Cool-1-2-3-4-5/Stewart-Platform/Mechanical/CAD/Stewart Platform.SLDASM

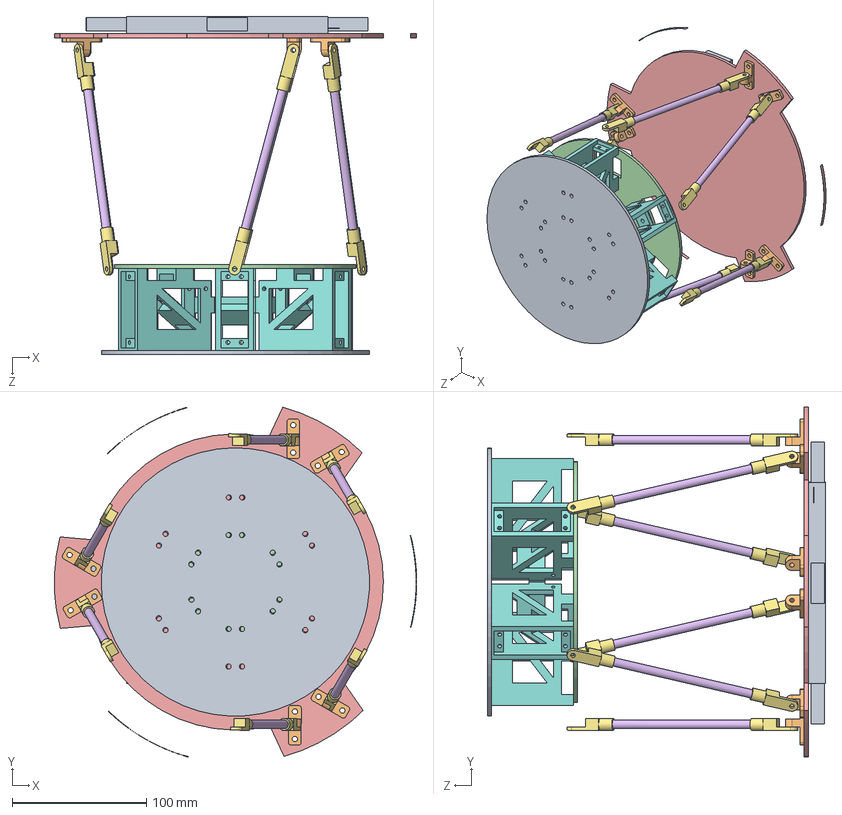
[picture p1: CAD file, 2026-11-09]
Mechanical/CAD/Stewart Platform.SLDASM
269.8 x 260.6 x 252.3 mm
Platform and Servo holder
Servo_HolderV.2 x 6
Aluminum holder x 12
Aluminum_Rod x 6
Top_Plane
Pi_mount
Start
bearingV2 x 6
Maze
