Cool-1-2-3-4-5/Stewart-Platform/Servo_Placers.SLDASM

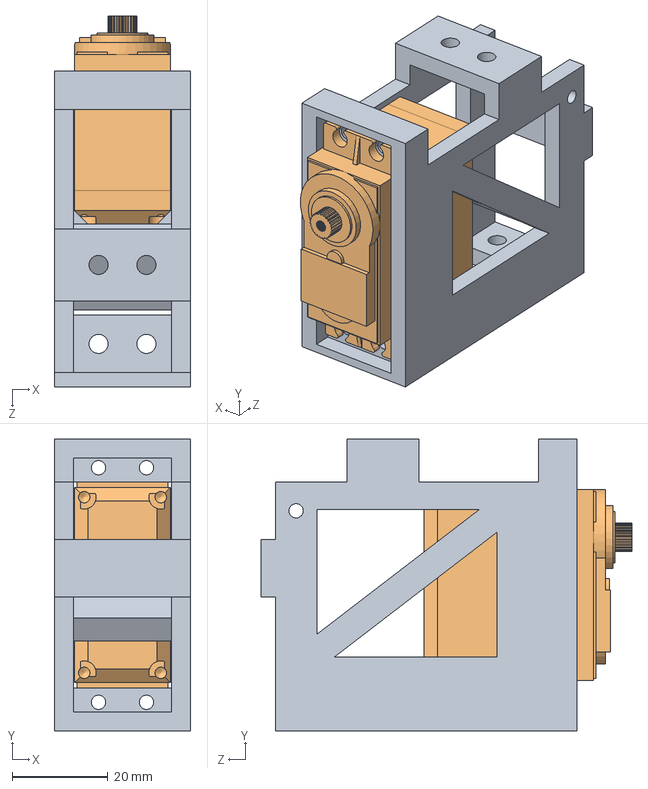
[picture p2: CAD file, 2026-10-27]
Servo_Placers.SLDASM
28.5 x 61.0 x 77.5 mm
Servo_HolderV.2
