Cool-1-2-3-4-5/Stewart-Platform/Stewart Platform.SLDASM

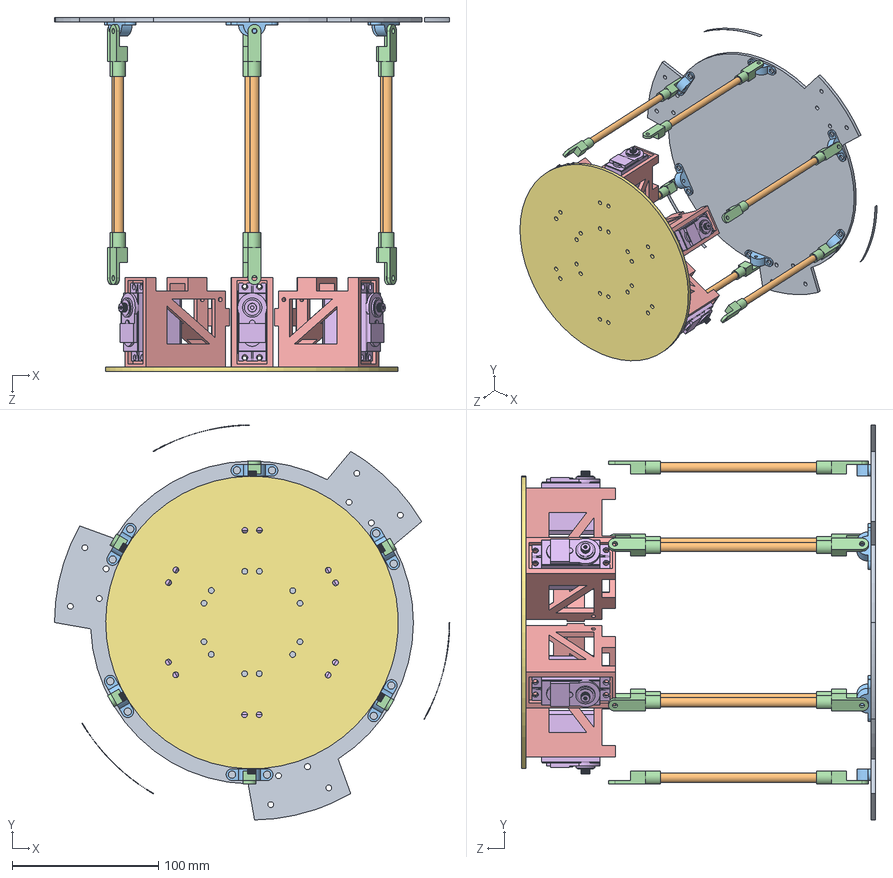
[picture p3: CAD file, 2026-10-27]
Stewart Platform.SLDASM
270.0 x 270.0 x 242.0 mm
Platform and Servo holder
Servo_HolderV.2 x 6
Aluminum holder x 12
Top_Bearing x 6
Aluminum_Rod x 6
Top_Plane
