Cool-1-2-3-4-5/Stewart-Platform/Mechanical/CAD/Maze.SLDPRT

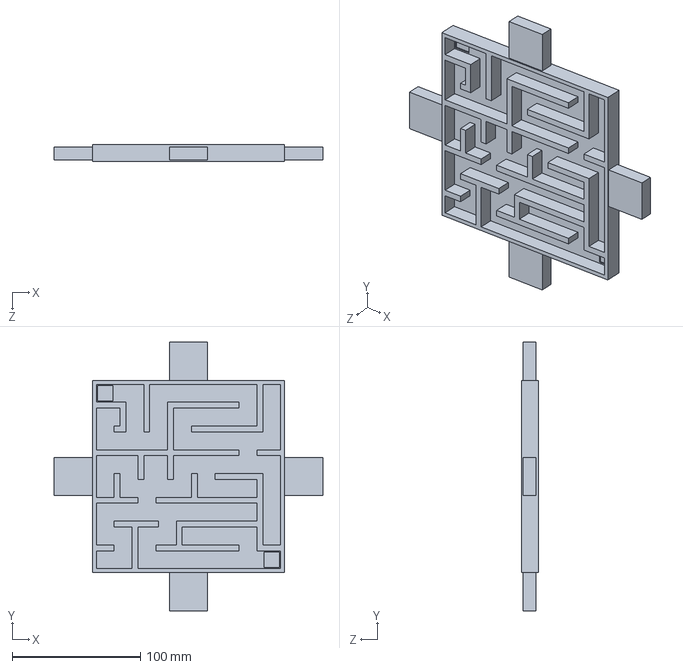
[picture p4: CAD file, 2026-11-09]
Mechanical/CAD/Maze.SLDPRT
210.0 x 210.0 x 13.0 mm
