Cool-1-2-3-4-5/Stewart-Platform/Mechanical/STL and DXF/bearingV2.STL

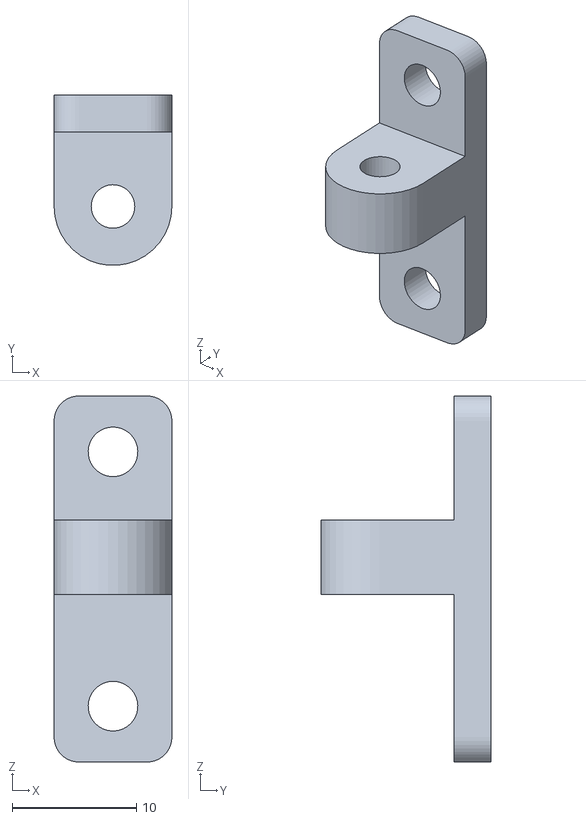
[picture p5: CAD file, 2026-11-09]
Mechanical/STL and DXF/bearingV2.STL
9.50 x 13.7 x 29.5
