Cool-1-2-3-4-5/Stewart-Platform/Platform and Servo holder.SLDPRT

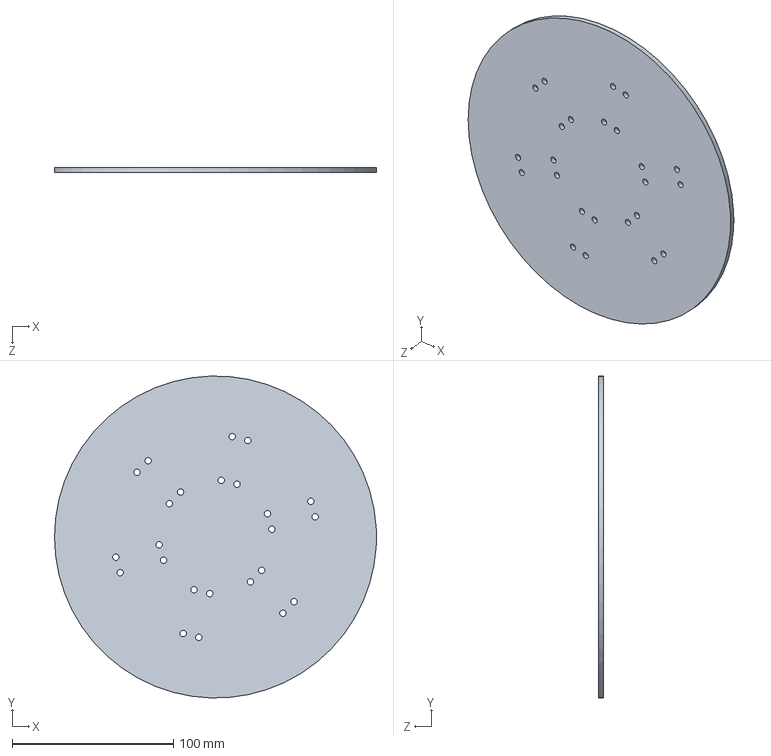
[picture p6: CAD file, 2026-10-27]
Platform and Servo holder.SLDPRT
200.0 x 199.9 x 3.17 mm
