Cool-1-2-3-4-5/Stewart-Platform/Mechanical/STL and DXF/Top_PlaneV3.DXF

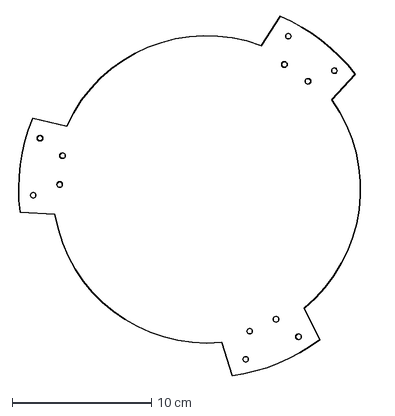
[picture p7: CAD file, 2026-11-09]
Mechanical/STL and DXF/Top_PlaneV3.DXF
26.0 x 25.8 cm
