Cool-1-2-3-4-5/Stewart-Platform/Servo_HolderV.5.STL

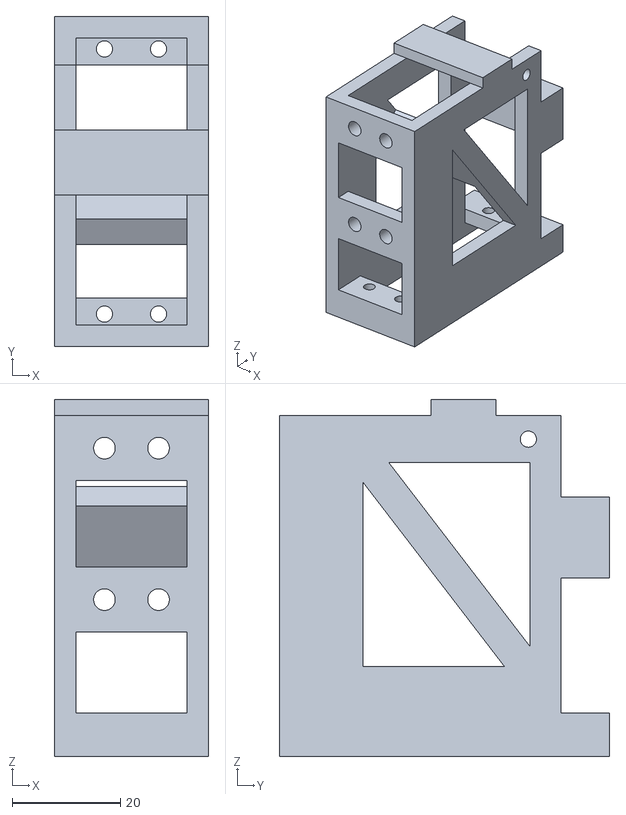
[picture p8: CAD file, 2026-10-27]
Servo_HolderV.5.STL
28.5 x 61.0 x 66.0
