Cool-1-2-3-4-5/Stewart-Platform/Bottom_PlateV3.DXF

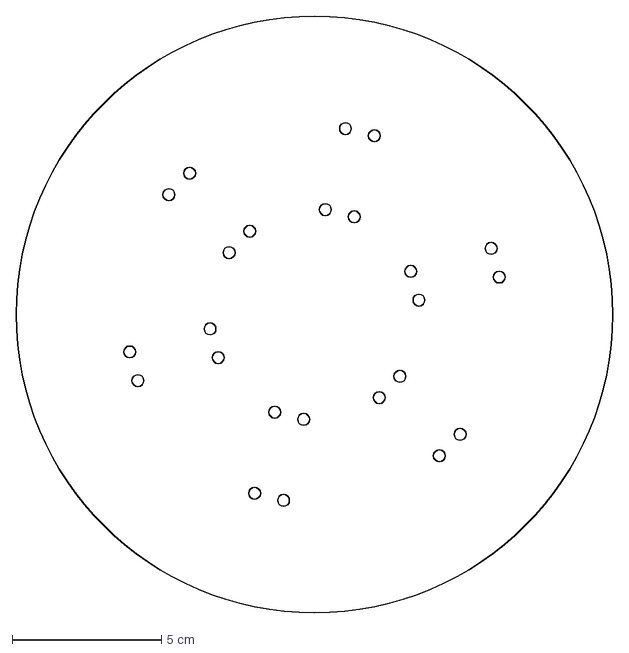
[picture p9: CAD file, 2026-10-27]
Bottom_PlateV3.DXF
20.0 x 20.0 cm
