Cool-1-2-3-4-5/Stewart-Platform/Mechanical/CAD/Top_Plane.SLDPRT

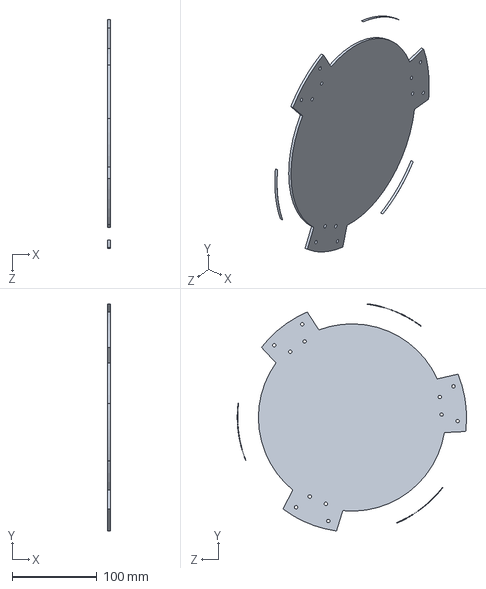
[picture p10: CAD file, 2026-11-09]
Mechanical/CAD/Top_Plane.SLDPRT
3.18 x 267.5 x 270.0 mm
