Cool-1-2-3-4-5/Stewart-Platform/Mechanical/STL and DXF/Maze_TopV2.DXF

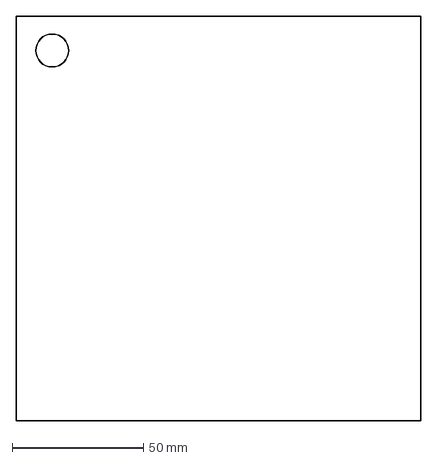
[picture p11: CAD file, 2026-11-05]
Mechanical/STL and DXF/Maze_TopV2.DXF
154.0 x 154.0 mm
