Cool-1-2-3-4-5/Stewart-Platform/Mechanical/STL and DXF/Maze.STL

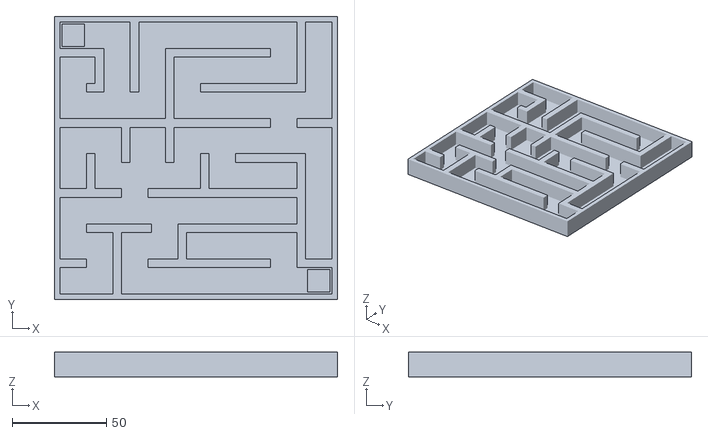
[picture p12: CAD file, 2026-11-05]
Mechanical/STL and DXF/Maze.STL
150.0 x 150.0 x 13.0
