Cool-1-2-3-4-5/Stewart-Platform/Mechanical/STL and DXF/Ball.STL

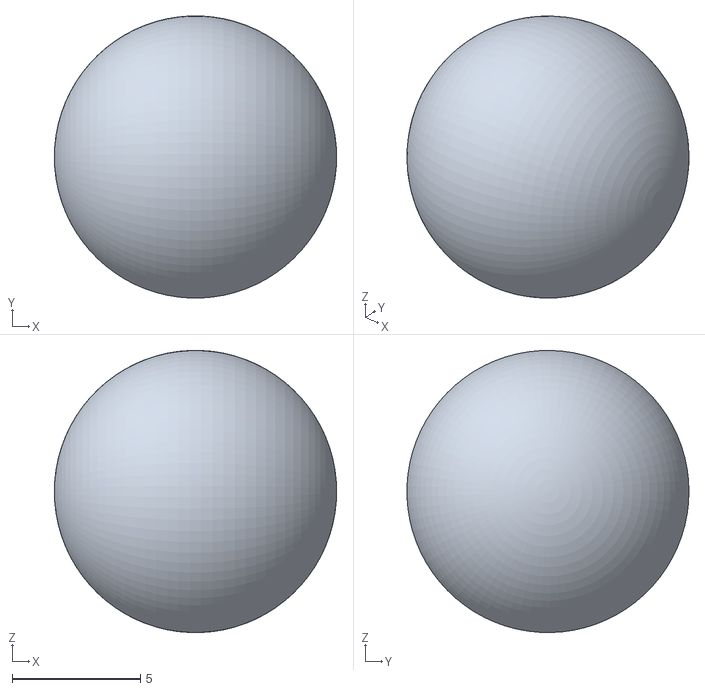
[picture p13: CAD file, 2026-11-05]
Mechanical/STL and DXF/Ball.STL
11.0 x 11.0 x 11.0
