Cool-1-2-3-4-5/Stewart-Platform/Servo_Holder.STL

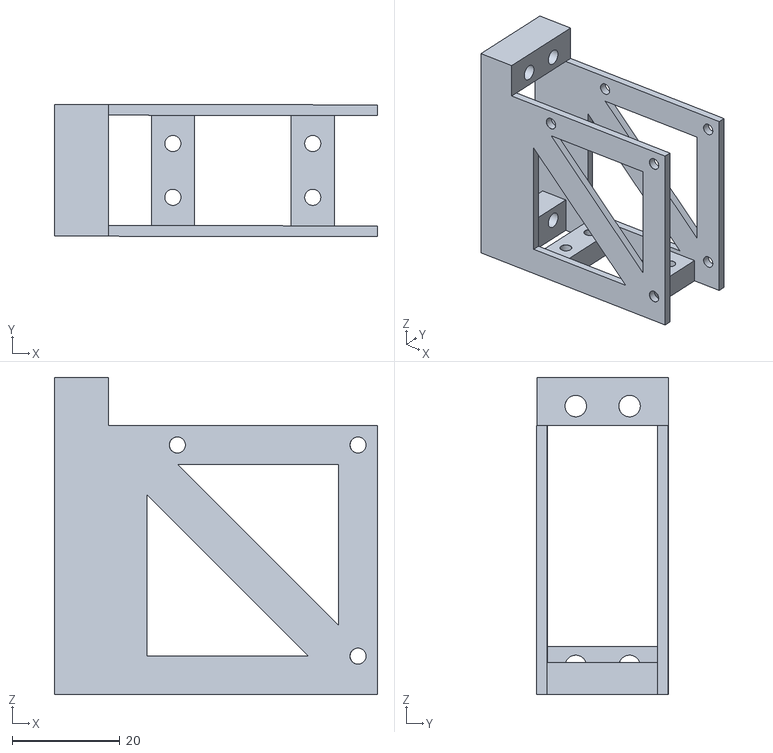
[picture p14: CAD file, 2026-10-27]
Servo_Holder.STL
60.0 x 24.6 x 59.0
