Cool-1-2-3-4-5/Stewart-Platform/Bottom_Plate.DXF

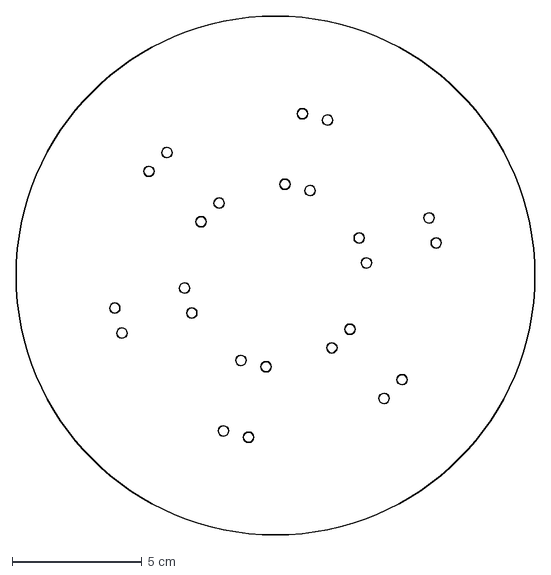
[picture p15: CAD file, 2026-10-27]
Bottom_Plate.DXF
20.0 x 20.0 cm
