Cool-1-2-3-4-5/Stewart-Platform/Mechanical/CAD/Aluminum holder.SLDPRT

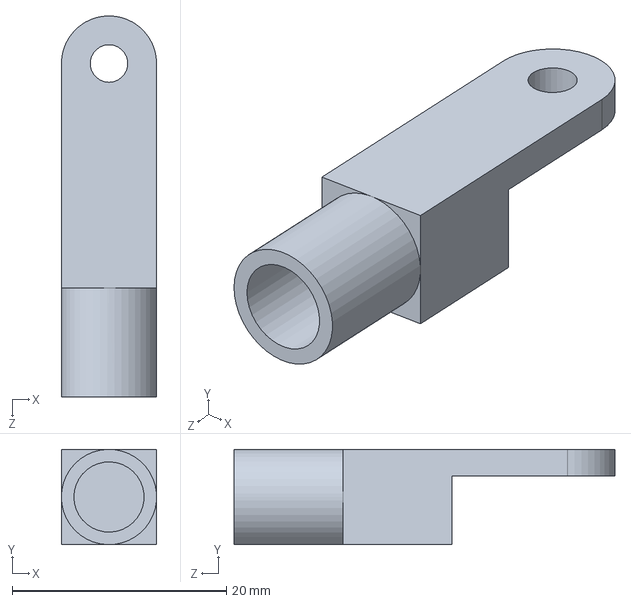
[picture p16: CAD file, 2026-11-09]
Mechanical/CAD/Aluminum holder.SLDPRT
8.89 x 8.89 x 35.5 mm
