Cool-1-2-3-4-5/Stewart-Platform/Mechanical/STL and DXF/Maze_top.DXF

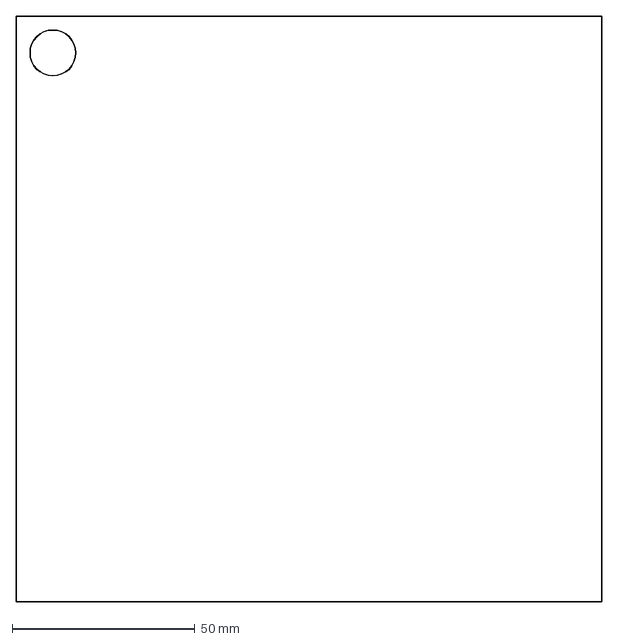
[picture p17: CAD file, 2026-11-05]
Mechanical/STL and DXF/Maze_top.DXF
160.0 x 160.0 mm
