Cool-1-2-3-4-5/Stewart-Platform/Mechanical/CAD/Pi_mount.SLDPRT

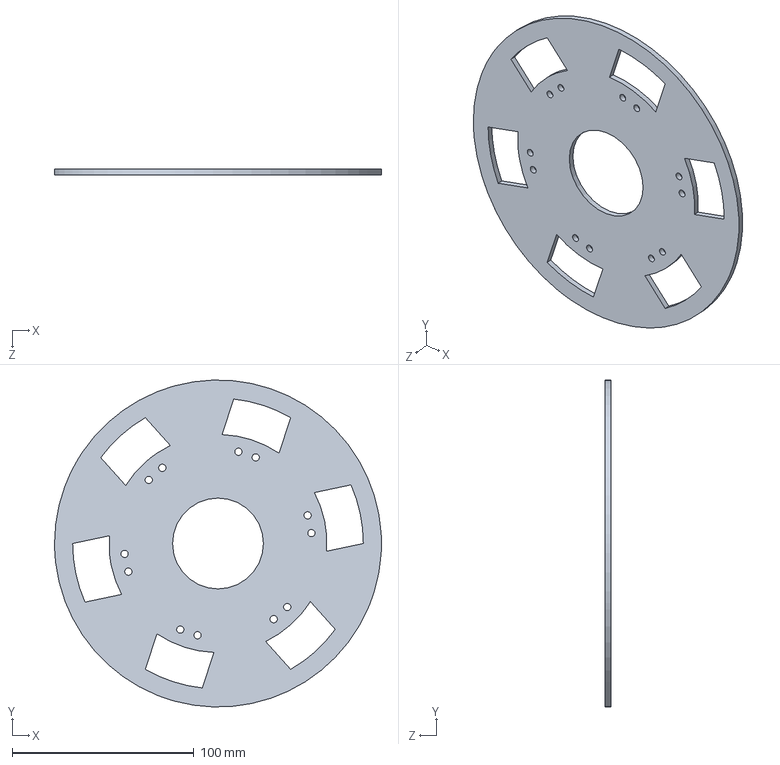
[picture p18: CAD file, 2026-11-09]
Mechanical/CAD/Pi_mount.SLDPRT
180.0 x 179.9 x 3.17 mm
