Cool-1-2-3-4-5/Stewart-Platform/Mechanical/STL and DXF/Pi_mountV2.DXF

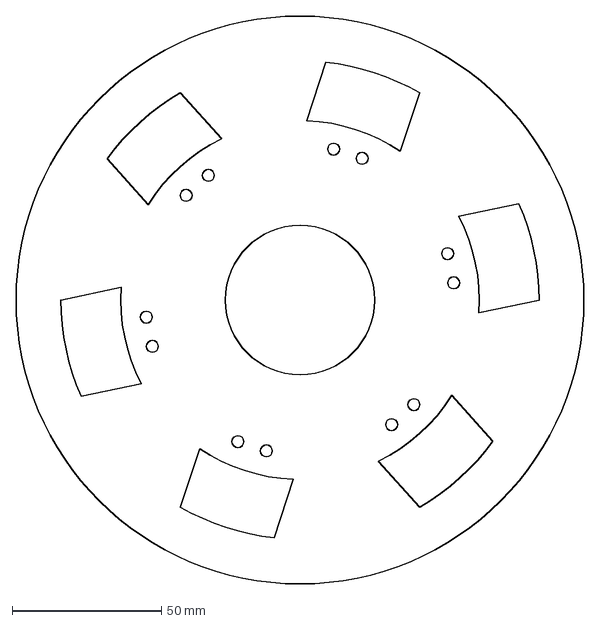
[picture p19: CAD file, 2026-11-05]
Mechanical/STL and DXF/Pi_mountV2.DXF
190.0 x 190.0 mm
