Cool-1-2-3-4-5/Stewart-Platform/2.45.SLDPRT

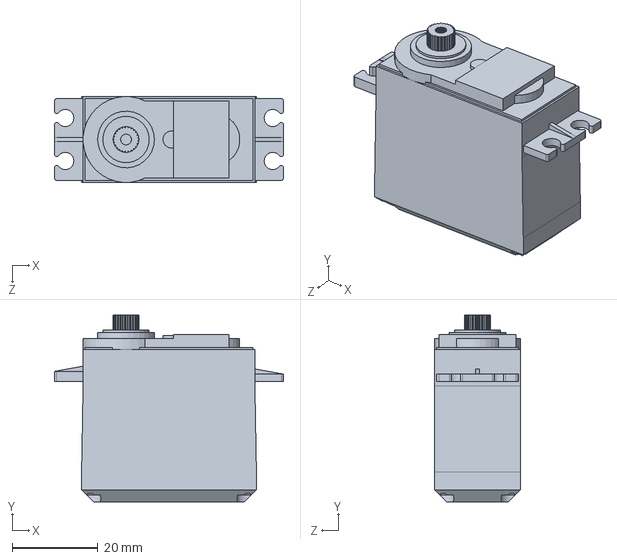
[picture p20: CAD file, 2026-10-27]
2.45.SLDPRT
53.3 x 43.5 x 20.0 mm
