Cool-1-2-3-4-5/Stewart-Platform/Mechanical/STL and DXF/Bottom_PlateV6.DXF

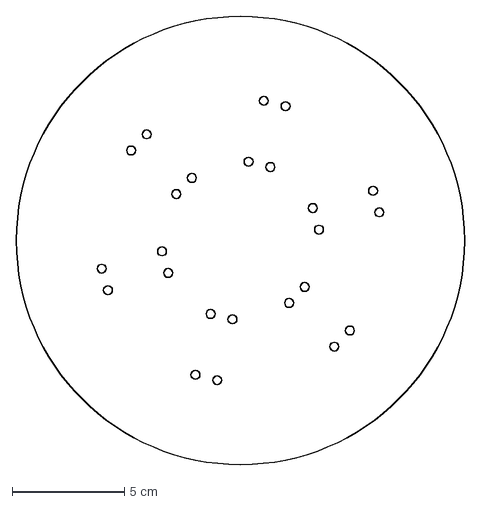
[picture p21: CAD file, 2026-11-05]
Mechanical/STL and DXF/Bottom_PlateV6.DXF
20.0 x 20.0 cm
