Cool-1-2-3-4-5/Stewart-Platform/Aluminium 25T Servo Horn.step

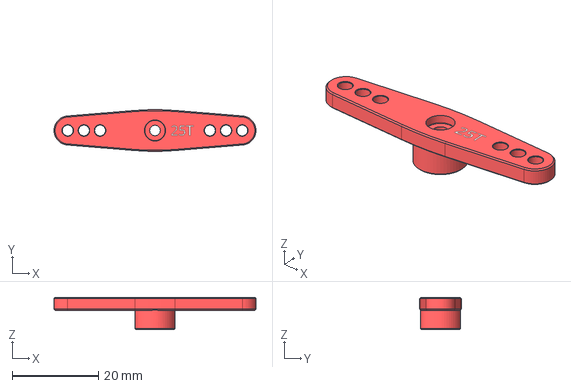
[picture p22: CAD file, 2026-10-27]
Aluminium 25T Servo Horn.step
46.9 x 9.66 x 7.50 mm
