Cool-1-2-3-4-5/Stewart-Platform/Mechanical/CAD/Maze_Top.SLDPRT

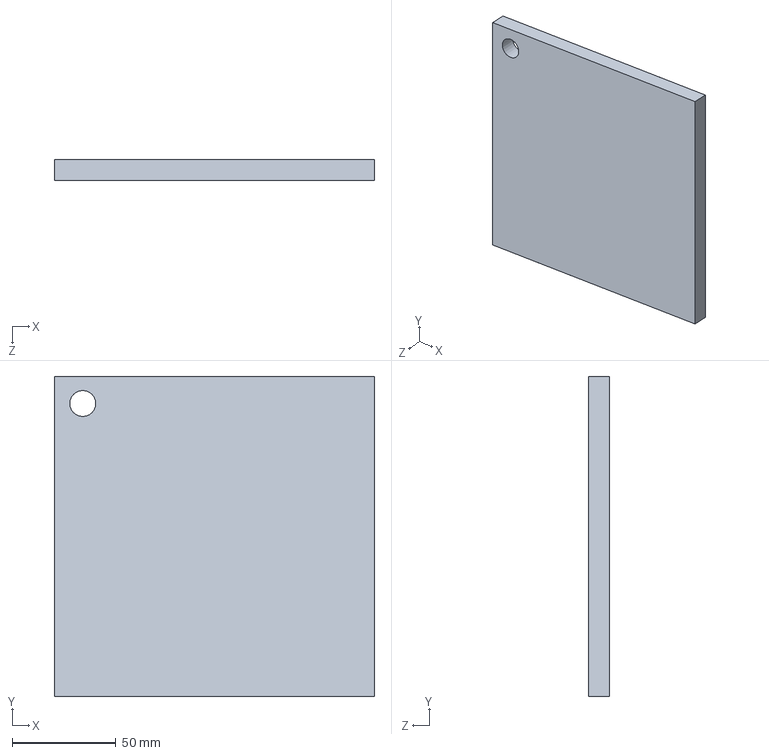
[picture p23: CAD file, 2026-11-05]
Mechanical/CAD/Maze_Top.SLDPRT
154.0 x 154.0 x 10.0 mm
