Cool-1-2-3-4-5/Stewart-Platform/Mechanical/CAD/Start.SLDPRT

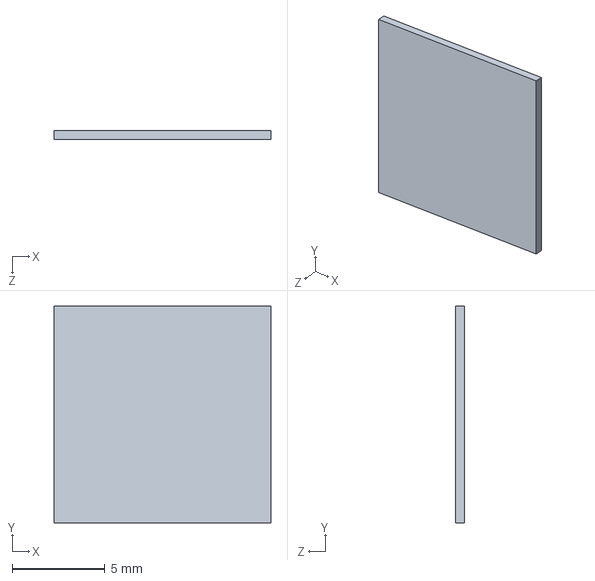
[picture p24: CAD file, 2026-11-05]
Mechanical/CAD/Start.SLDPRT
11.7 x 11.7 x 0.5 mm
