Cool-1-2-3-4-5/Stewart-Platform/Mechanical/CAD/Spacers.SLDPRT

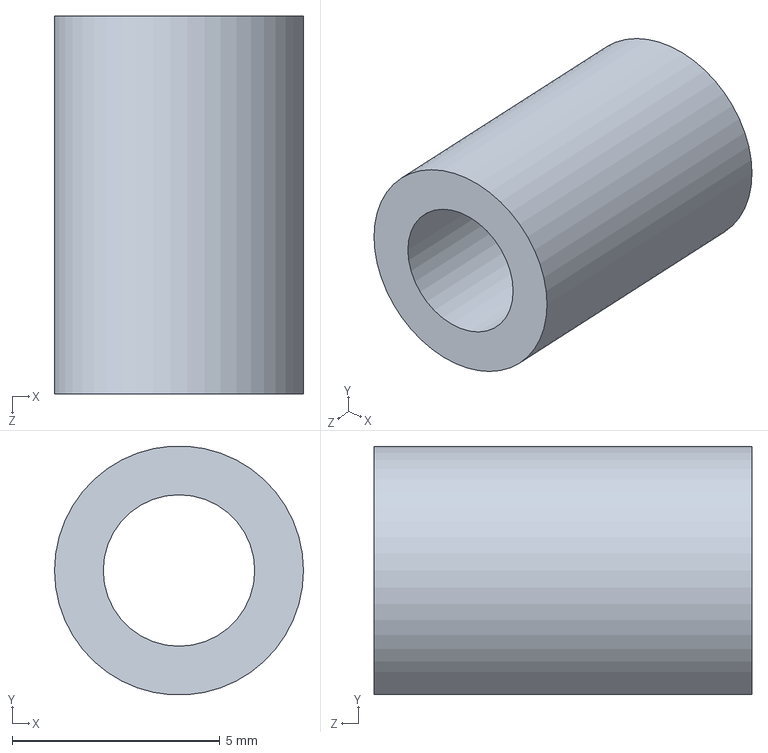
[picture p26: CAD file, 2026-10-30]
Mechanical/CAD/Spacers.SLDPRT
6.00 x 5.99 x 9.10 mm
