Cool-1-2-3-4-5/Stewart-Platform/Mechanical/CAD/Spacer.SLDPRT

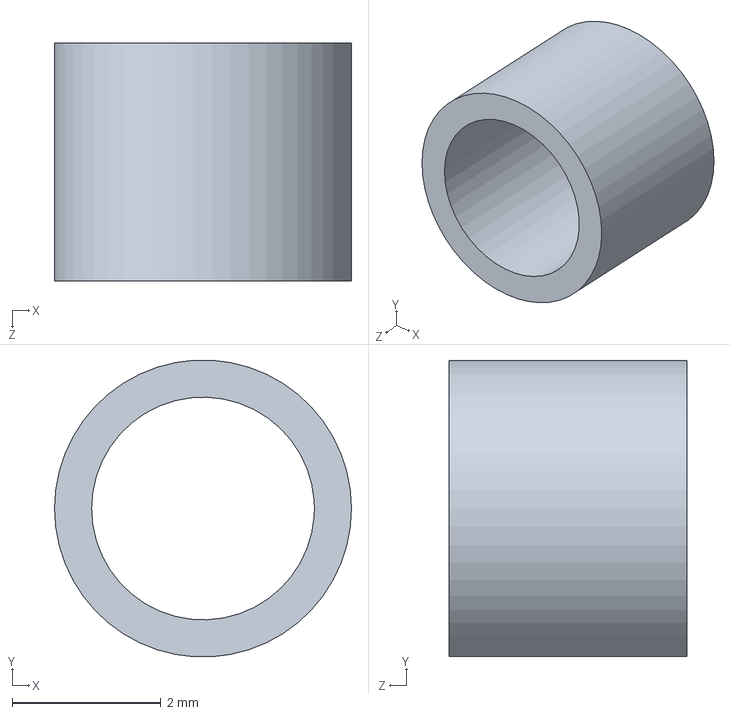
[picture p27: CAD file, 2026-10-29]
Mechanical/CAD/Spacer.SLDPRT
4.00 x 3.99 x 3.20 mm
