Cool-1-2-3-4-5/Stewart-Platform/Top_Plane.SLDPRT

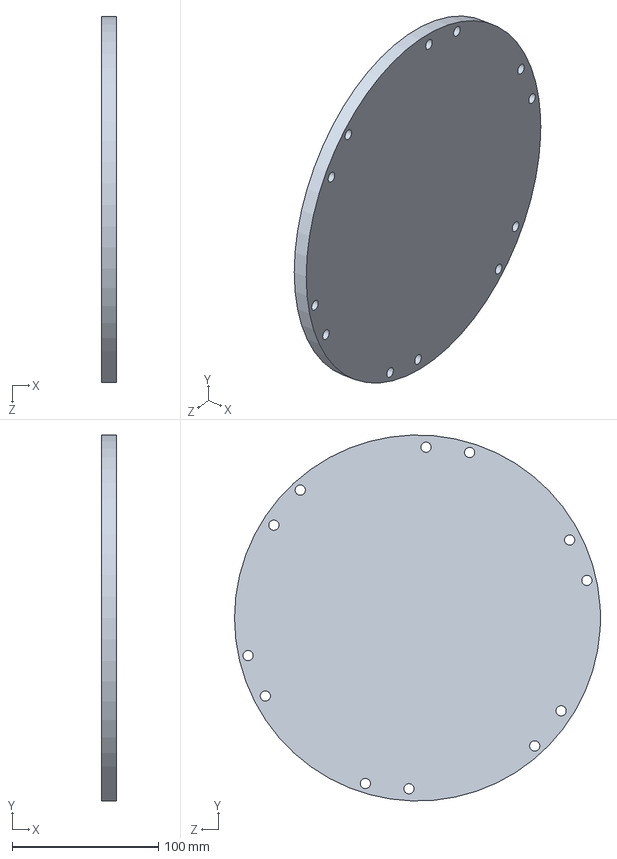
[picture p28: CAD file, 2026-10-27]
Top_Plane.SLDPRT
10.0 x 249.9 x 250.0 mm
