Cool-1-2-3-4-5/Stewart-Platform/Mechanical/CAD/Cap.SLDPRT

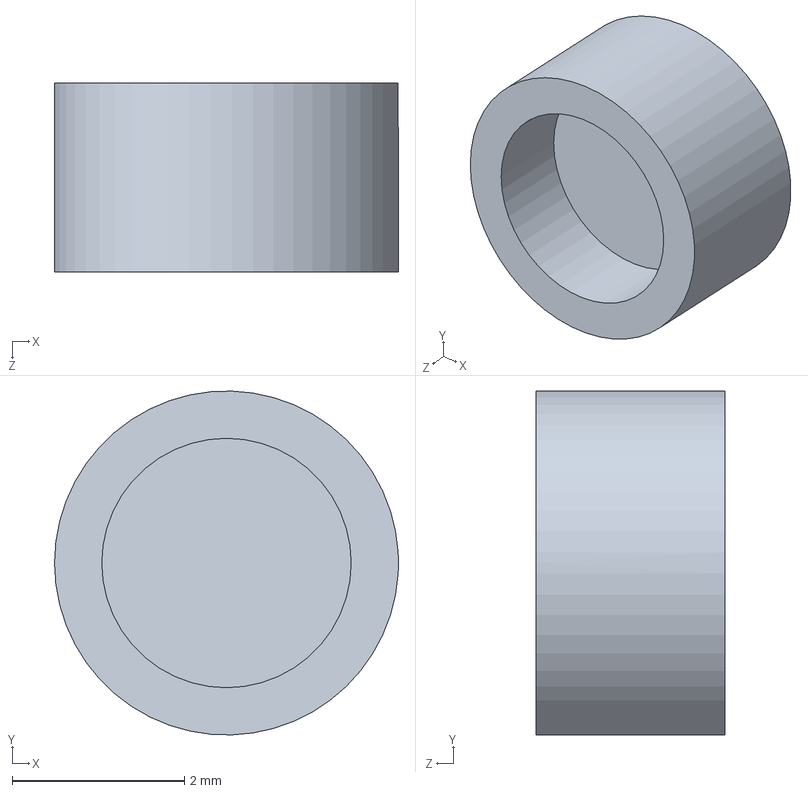
[picture p29: CAD file, 2026-10-29]
Mechanical/CAD/Cap.SLDPRT
4.00 x 4.00 x 2.20 mm
