Cool-1-2-3-4-5/Stewart-Platform/Mechanical/STL and DXF/Pi_mount.STL

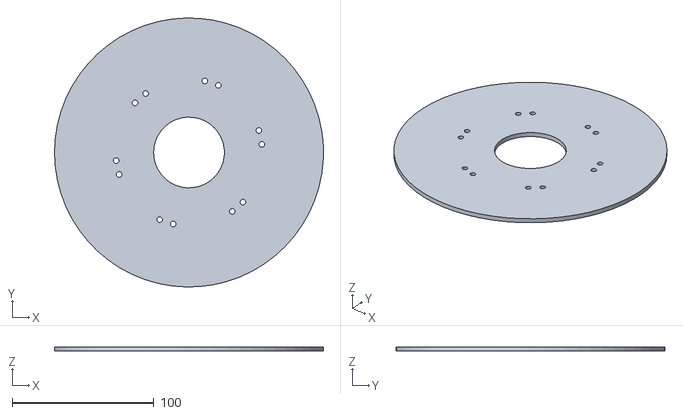
[picture p30: CAD file, 2026-10-30]
Mechanical/STL and DXF/Pi_mount.STL
190.0 x 189.9 x 3.17
