Cool-1-2-3-4-5/Stewart-Platform/Mechanical/CAD/Aluminum_holder_Bottom.SLDPRT

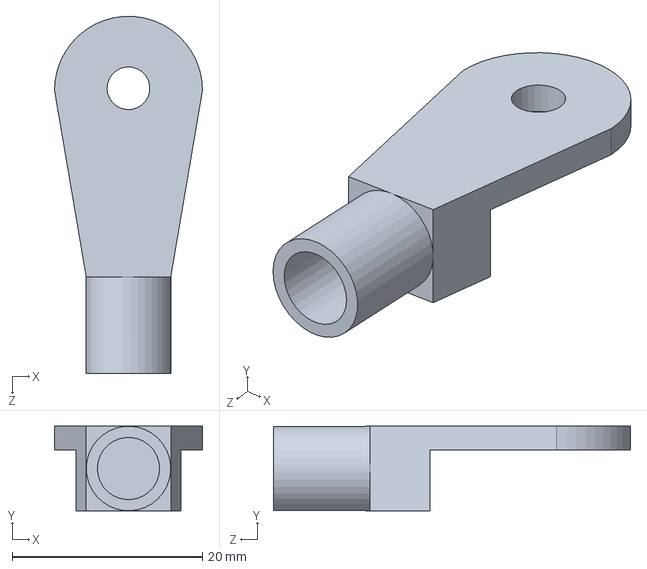
[picture p31: CAD file, 2026-10-29]
Mechanical/CAD/Aluminum_holder_Bottom.SLDPRT
15.6 x 8.89 x 37.6 mm
