Cool-1-2-3-4-5/Stewart-Platform/Mechanical/STL and DXF/slotter.STL

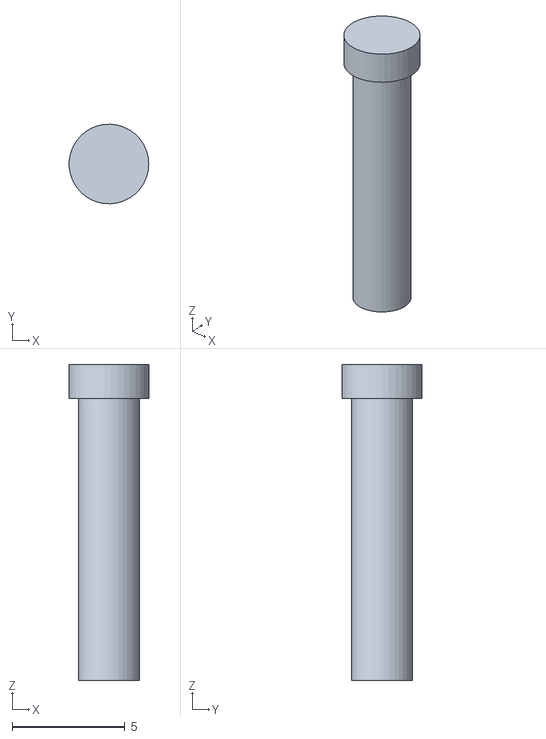
[picture p32: CAD file, 2026-10-29]
Mechanical/STL and DXF/slotter.STL
3.53 x 3.53 x 14.0
