Cool-1-2-3-4-5/Stewart-Platform/Mechanical/CAD/Top_Bearing.SLDPRT

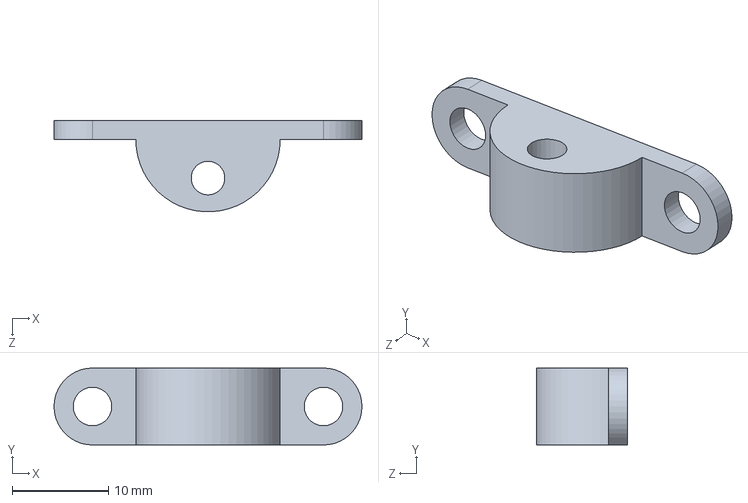
[picture p33: CAD file, 2026-10-29]
Mechanical/CAD/Top_Bearing.SLDPRT
32.0 x 8.00 x 9.49 mm
