Cool-1-2-3-4-5/Stewart-Platform/Rod_Holder.STL

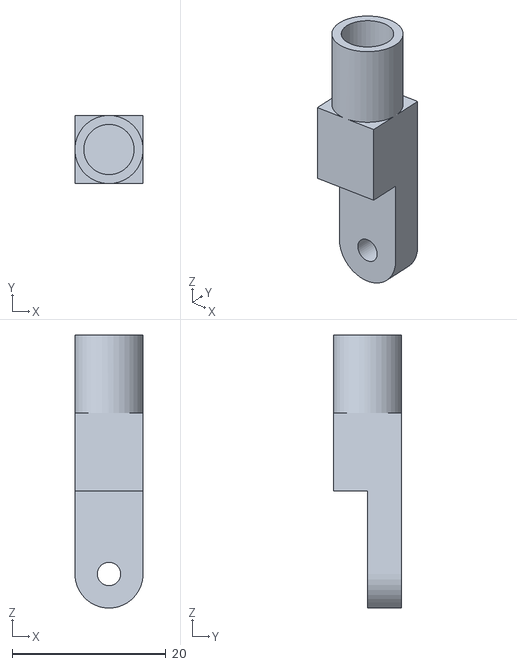
[picture p34: CAD file, 2026-10-27]
Rod_Holder.STL
8.89 x 8.89 x 35.5
