Cool-1-2-3-4-5/Stewart-Platform/Mechanical/CAD/Aluminum_Rod.SLDPRT

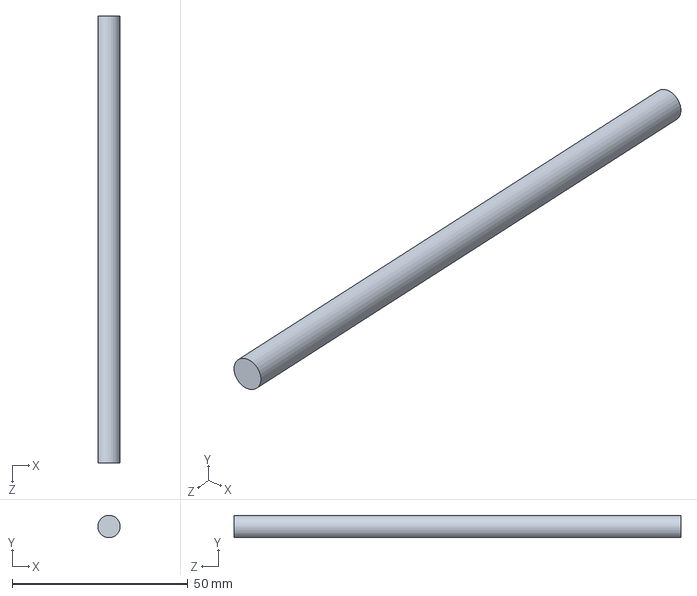
[picture p35: CAD file, 2026-10-29]
Mechanical/CAD/Aluminum_Rod.SLDPRT
6.35 x 6.34 x 127.0 mm
