Cool-1-2-3-4-5/Stewart-Platform/Mechanical/CAD/Servo_Holder.SLDPRT

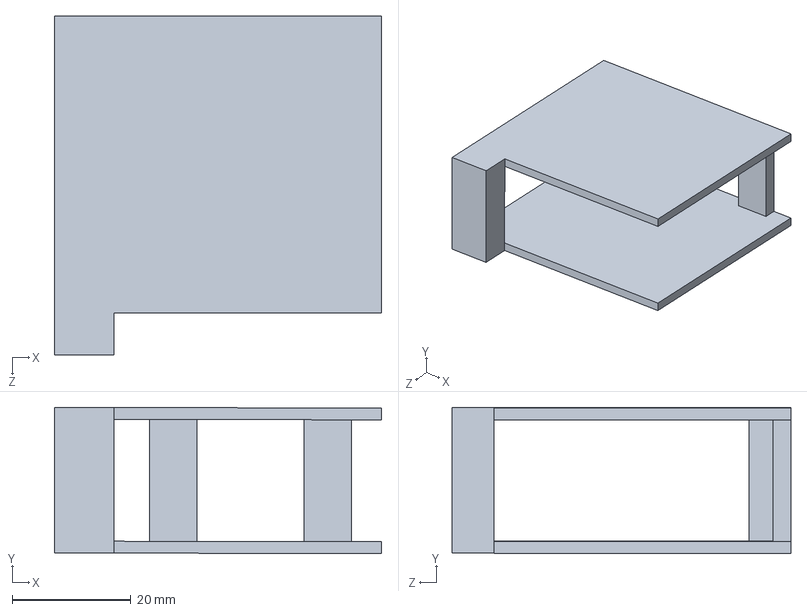
[picture p36: CAD file, 2026-10-29]
Mechanical/CAD/Servo_Holder.SLDPRT
55.0 x 24.6 x 57.0 mm
