Cool-1-2-3-4-5/Stewart-Platform/Mechanical/CAD/Servo_Placers.SLDASM

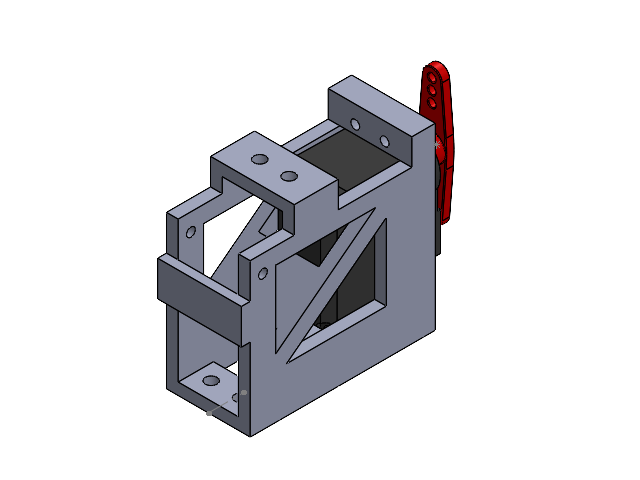
[picture p37: CAD file, 2026-11-09]
Mechanical/CAD/Servo_Placers.SLDASM
Motor
Servo_HolderV.2
Aluminium 25T Servo Horn.step
