Cool-1-2-3-4-5/Stewart-Platform/(list of files, cad)

Other CAD files:
Mechanical/CAD/Platform and Servo holder.SLDPRT
Mechanical/CAD/bearingV2.SLDPRT
Mechanical/STL and DXF/Start.STL
Mechanical/CAD/Ball.SLDPRT
Aluminum holder.SLDPRT
Mechanical/STL and DXF/Spacers.STL
Mechanical/STL and DXF/Top_Bearing.STL
Mechanical/CAD/slotter.SLDPRT
Mechanical/STL and DXF/Cap.STL
Mechanical/CAD/Servo_HolderV.2.SLDPRT
Mechanical/STL and DXF/Aluminum_holder_3.5_bottom.STL
Mechanical/STL and DXF/Top_Bearing_3.5.STL
Mechanical/STL and DXF/Spacer.STL
Mechanical/STL and DXF/Aluminum_holder_Bottom.STL
Mechanical/CAD/Washer.SLDPRT
Mechanical/STL and DXF/Bottom_PlateV4.DXF
Mechanical/STL and DXF/Bottom_PlateV5.DXF
Mechanical/STL and DXF/Pi_mount.DXF
Mechanical/STL and DXF/Top_Plane.DXF
Mechanical/STL and DXF/Top_PlaneV2.DXF
Mechanical/STL and DXF/Washer.STL
Servo_HolderV.2.STL
Servo_HolderV.3.STL
Servo_HolderV.4.STL
